Roman5D/Kondrashova_Kochurin/Манипулятор/Картинки/Пример робота.jpg

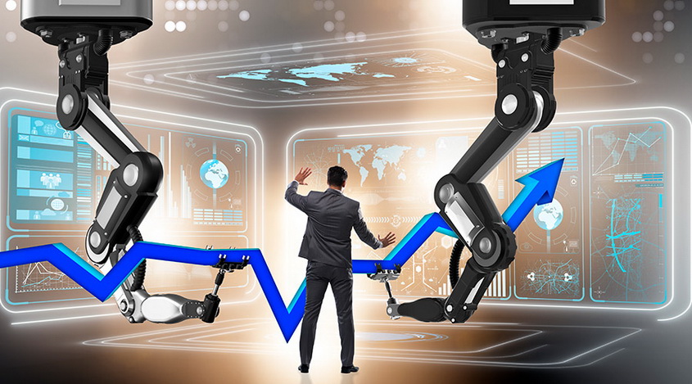
Манипулятор/Картинки/Пример робота.jpg
