Roman5D/Kondrashova_Kochurin/README.md

# Kondrashova_Kochurin
3341506/10401

В фалах main есть секции, в которых производится чтение mat файлов и вывод графиков (никаких долгих пересчётов).
