Roman5D/Kondrashova_Kochurin/Манипулятор/Картинки/Cхема 1.png

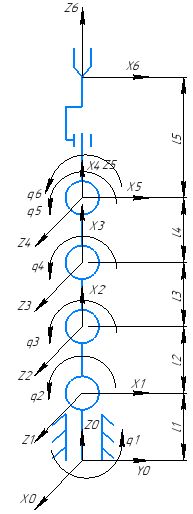
Манипулятор/Картинки/Cхема 1.png
