Roman5D/Kondrashova_Kochurin/Объединение/Scaling.png

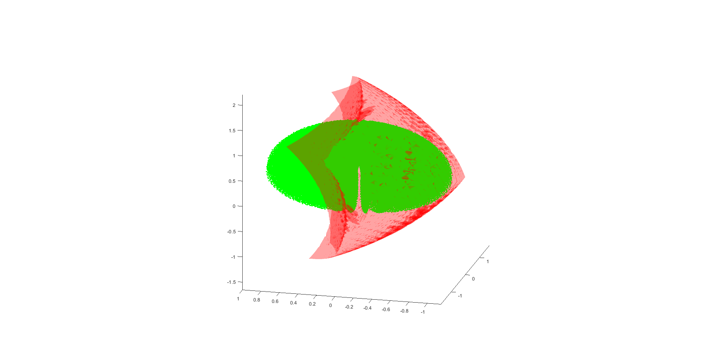
Объединение/Scaling.png
