Roman5D/Kondrashova_Kochurin/Дельта робот/3D-модель дельта-робота/DELTA_SB.SLDASM

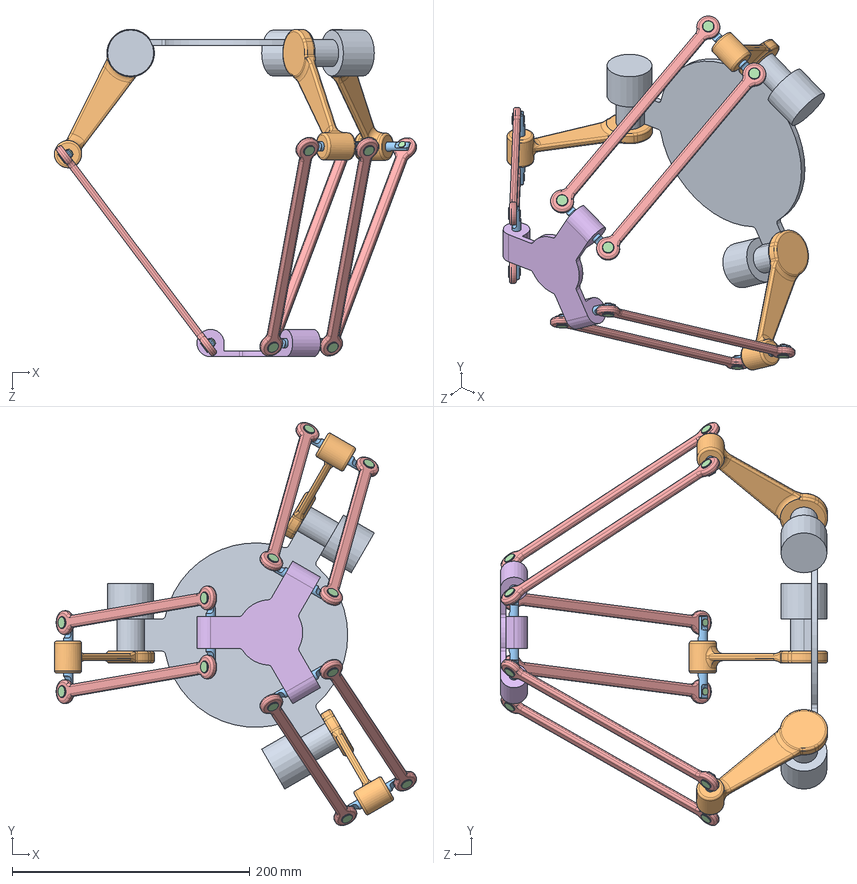
[picture p48: CAD file, 2022-03-20]
Дельта робот/3D-модель дельта-робота/DELTA_SB.SLDASM
304.6 x 338.8 x 275.3 mm
plactina_1
richag x 3
val x 6
vtulka x 12
spica x 6
plastina_2
