Roman5D/Kondrashova_Kochurin/Дельта робот/3D-модель дельта-робота/richag.SLDPRT

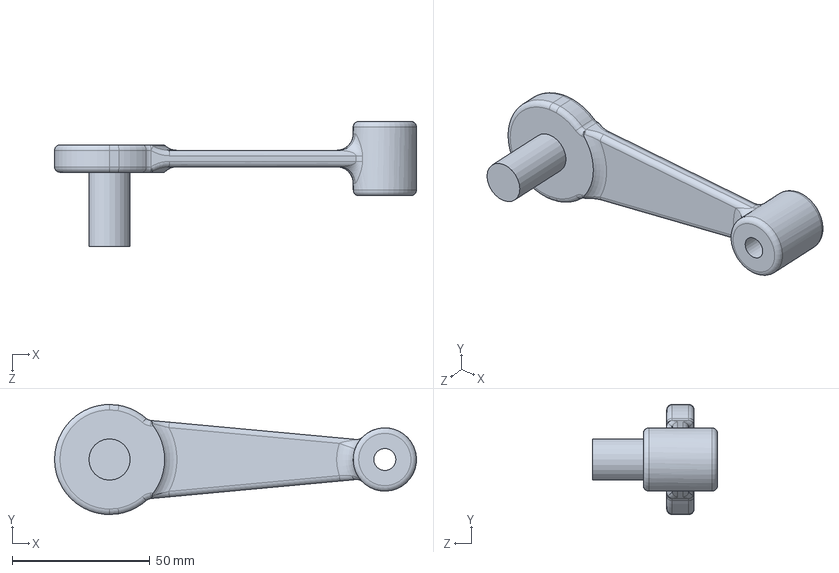
[picture p49: CAD file, 2022-03-20]
Дельта робот/3D-модель дельта-робота/richag.SLDPRT
131.5 x 40.0 x 45.5 mm
