Roman5D/Kondrashova_Kochurin/Манипулятор/Компоненты/Модель csf-mini с сайта/CSF_14_30_1U_CC_F_1.stp

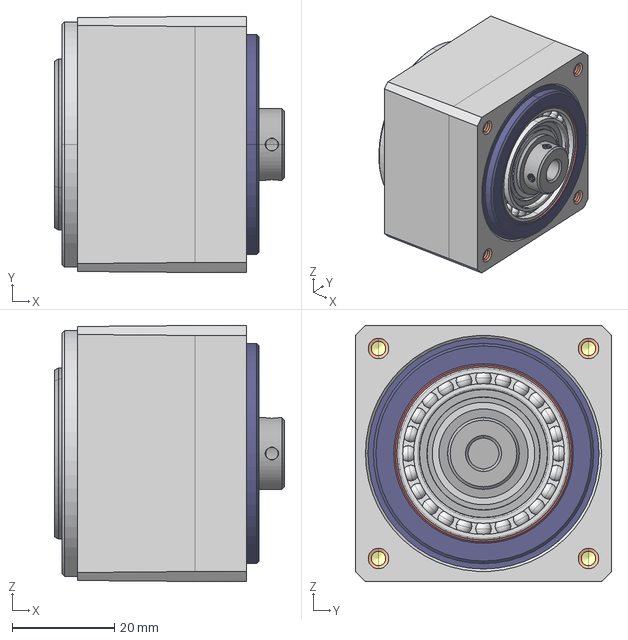
[picture p50: CAD file, 2022-05-11]
Манипулятор/Компоненты/Модель csf-mini с сайта/CSF_14_30_1U_CC_F_1.stp
45.0 x 50.0 x 50.0 mm
