Roman5D/Kondrashova_Kochurin/Дельта робот/3D-модель дельта-робота/val.SLDPRT

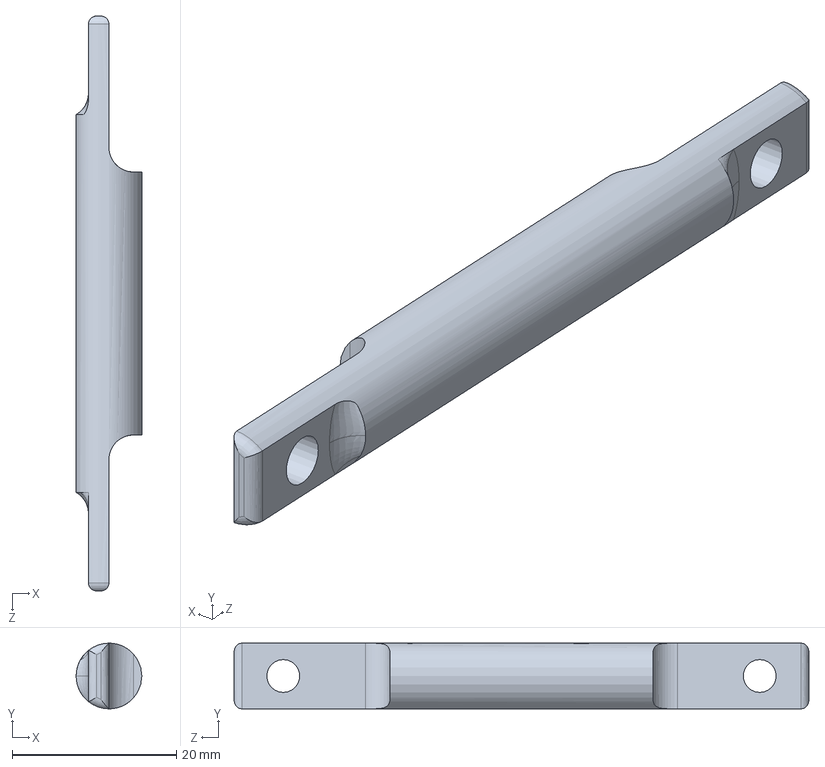
[picture p51: CAD file, 2022-03-20]
Дельта робот/3D-модель дельта-робота/val.SLDPRT
8.00 x 8.00 x 70.0 mm
