Roman5D/Kondrashova_Kochurin/Дельта робот/3D-модель дельта-робота/vtulka.SLDPRT

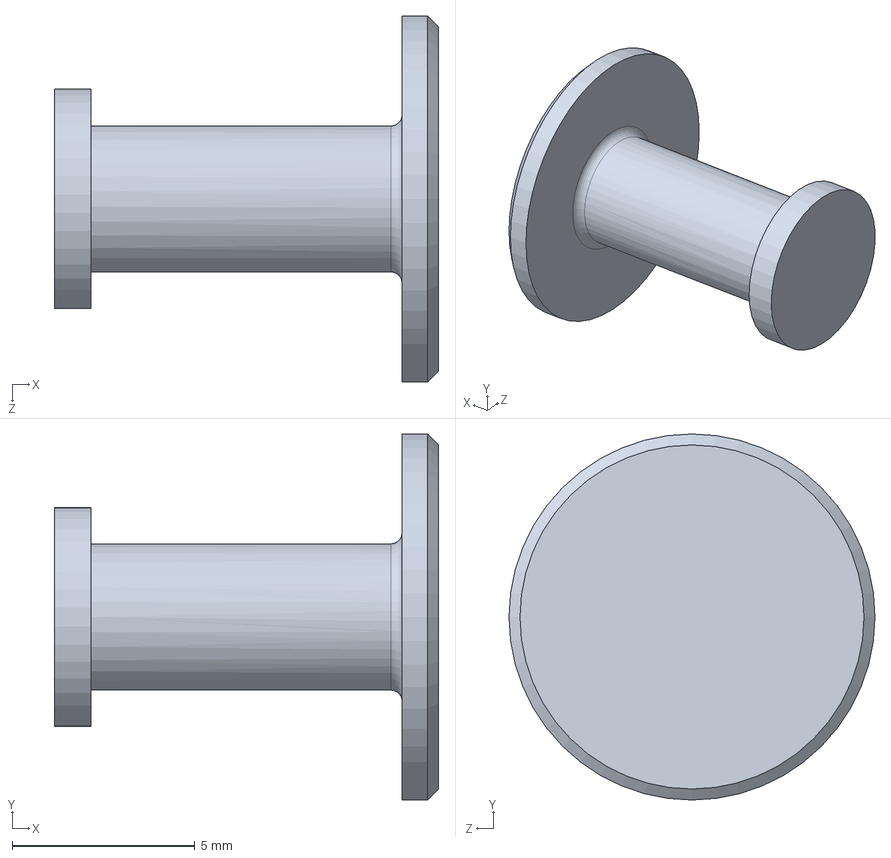
[picture p52: CAD file, 2022-03-20]
Дельта робот/3D-модель дельта-робота/vtulka.SLDPRT
10.5 x 10.0 x 10.0 mm
