Roman5D/Kondrashova_Kochurin/Дельта робот/3D-модель дельта-робота/plastina_2.SLDPRT

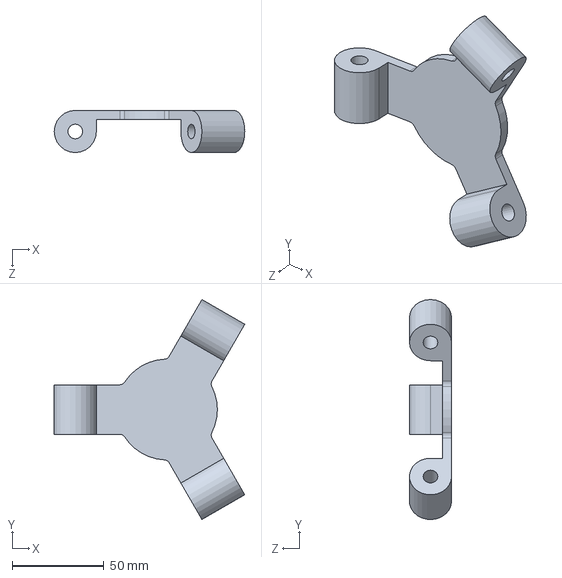
[picture p53: CAD file, 2022-03-20]
Дельта робот/3D-модель дельта-робота/plastina_2.SLDPRT
103.9 x 120.0 x 23.0 mm
