Roman5D/Kondrashova_Kochurin/Дельта робот/3D-модель дельта-робота/spica.SLDPRT

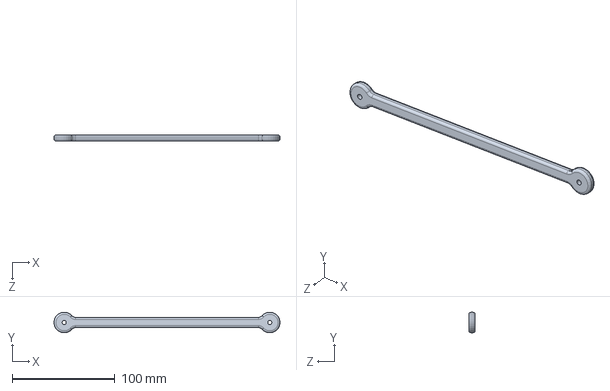
[picture p54: CAD file, 2022-03-20]
Дельта робот/3D-модель дельта-робота/spica.SLDPRT
219.9 x 19.9 x 6.00 mm
