Roman5D/Kondrashova_Kochurin/Дельта робот/3D-модель дельта-робота/plactina_1.SLDPRT

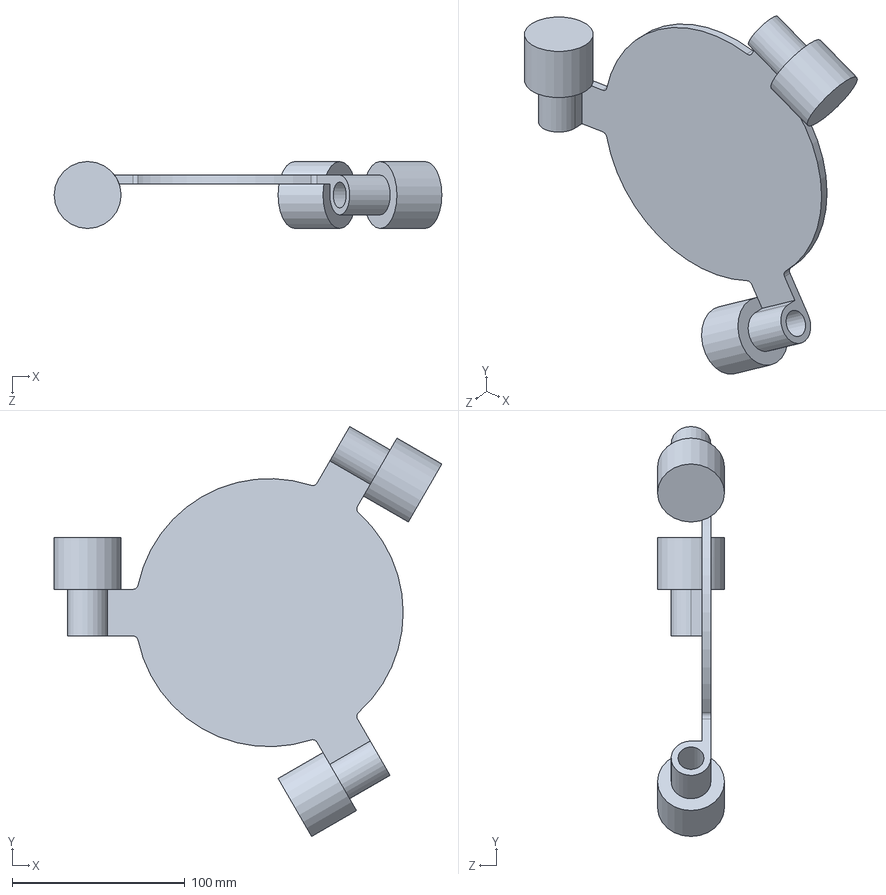
[picture p55: CAD file, 2022-03-20]
Дельта робот/3D-модель дельта-робота/plactina_1.SLDPRT
224.2 x 237.1 x 38.7 mm
