Roman5D/Kondrashova_Kochurin/Манипулятор/Компоненты/Шарнир 4.pdf

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

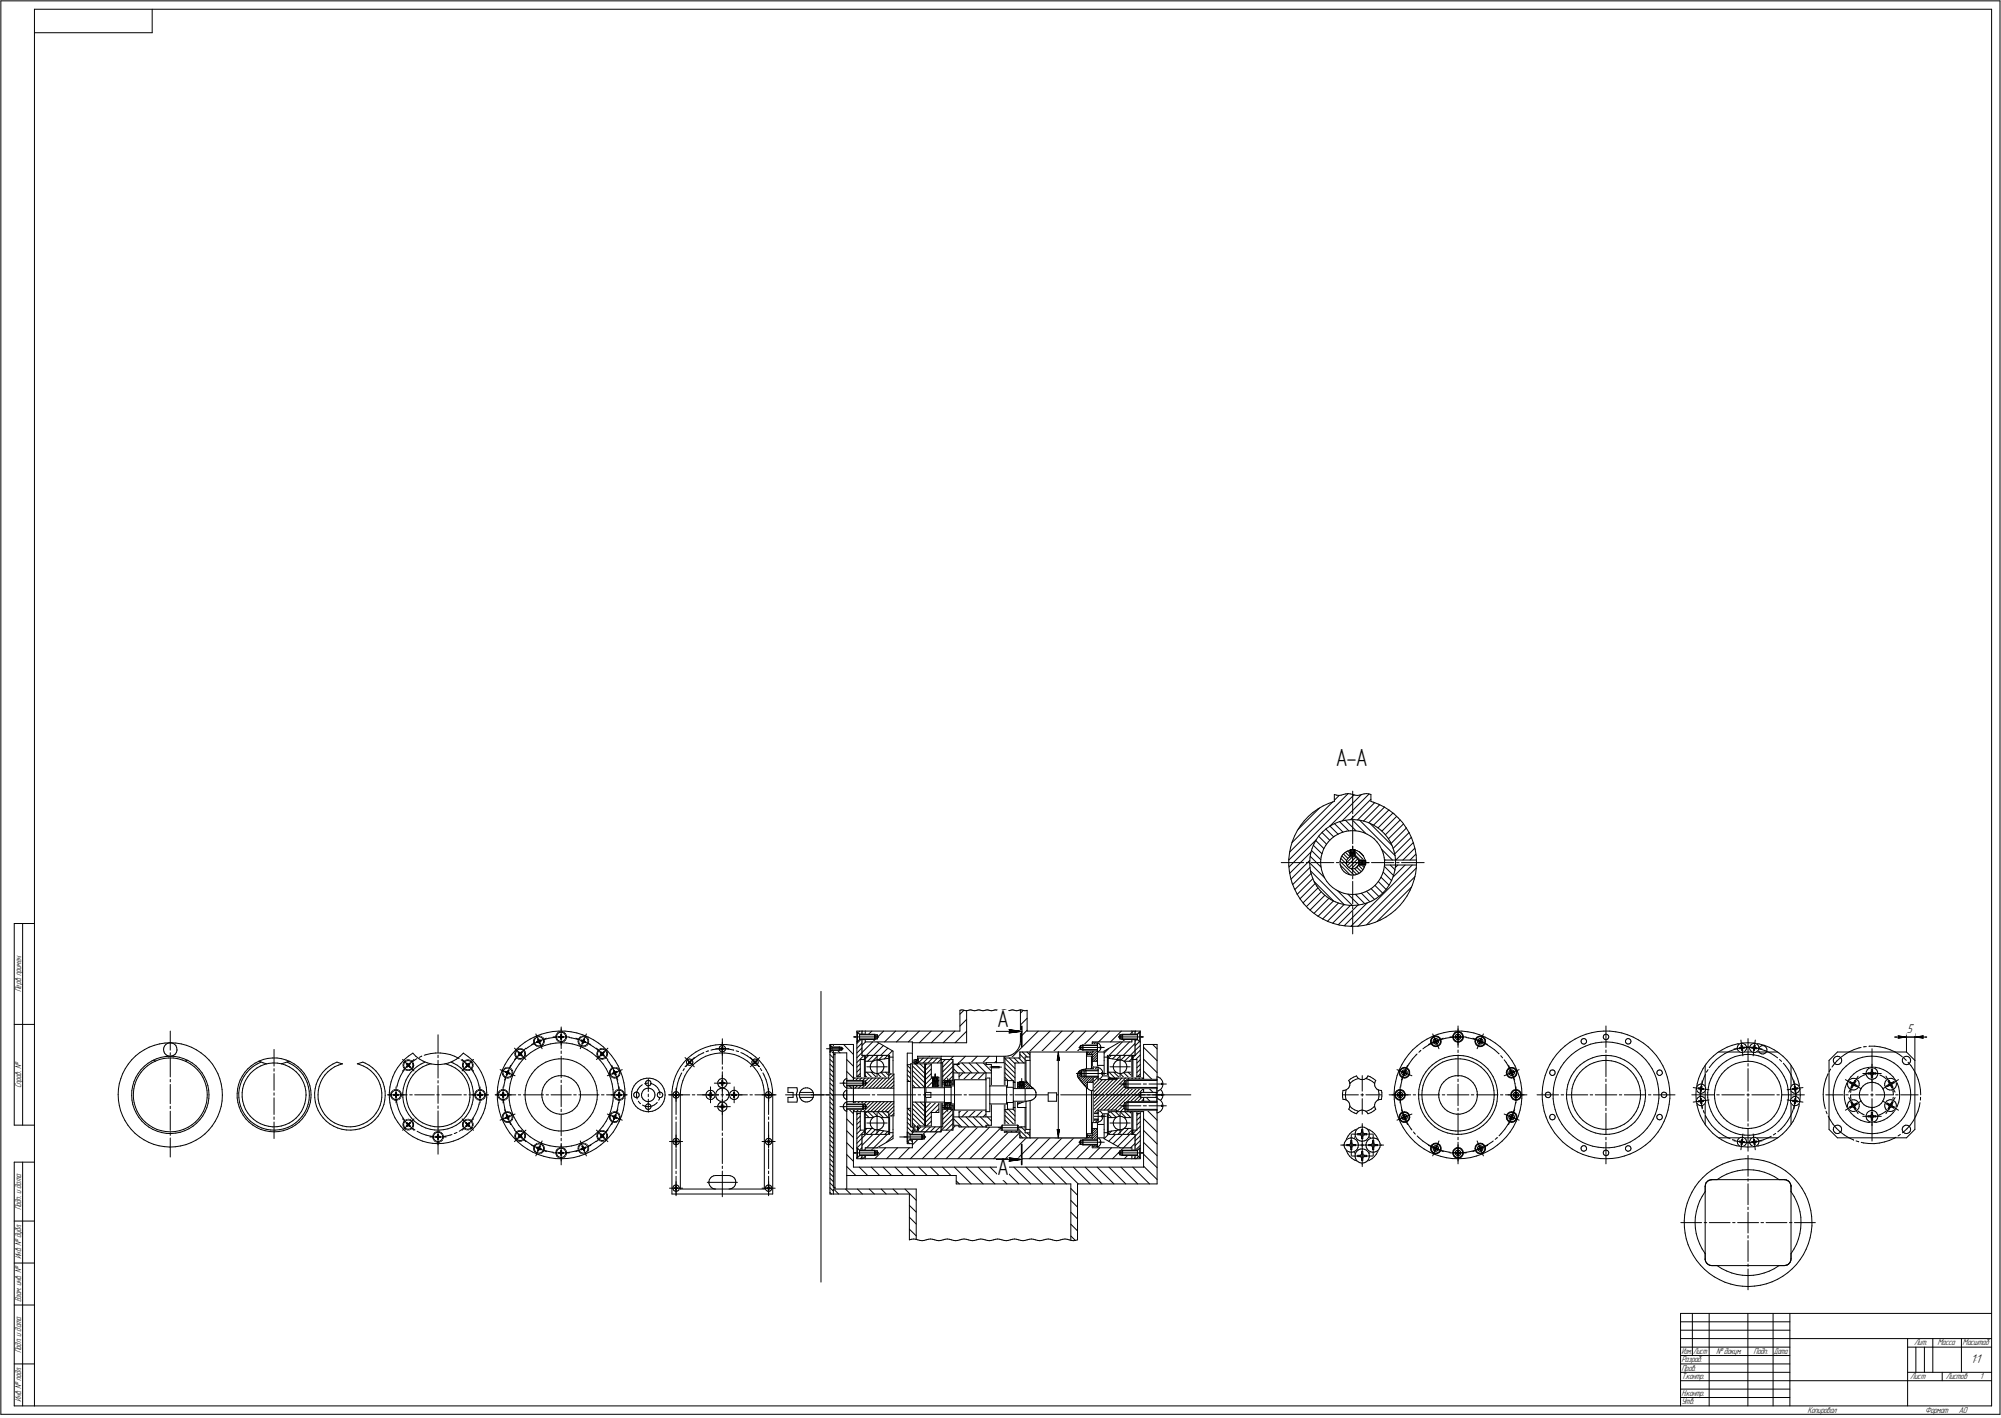
[picture p56: page 1]
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
