Roman5D/Kondrashova_Kochurin/(commit log)

2022-03-20 Вывод из сохраненного
    Исправлены старые ошибки, добавлены новые ошибки
2022-03-26 Мелкие правки
2022-03-28 Добавлен сохранение и загрузка
    Сохранение и загрузка объединённых зон
2022-04-30 Последняя версия файлов
    Началась работа над чертежами
    [CSG_25_50_2UH_1.stp]
2022-05-01 Отчёт обновлён
2022-05-01 Добавлен чертёж 4-го шарнира
    [CSG_25_50_2UH_1.stp]
2022-05-02 Исправил отображение подшипников
2022-05-11 Шарнир №4, который пятый
    Исправлен чертёж шарнира.
    Добавлена модель редуктора с сайта производителя.
    Небольшие правки отчёта
    [CSF_14_30_1U_CC_F_1.stp]
2022-05-11 Мелкая правка
    Исправил отверстие для крепления в корпусе
2022-05-11 Исправления и добавления
    Заменил датчик угла пятого шарнира.
    Добавил общую концепцию компонентов пятого шарнира.
2022-05-20 Шарнир 6
    Добавил концепцию шарнира 6 (он же седьмой, который схват).
    Мелкие правки четвёртого и пятого шарниров.
2022-05-25 Читать описание
    Внесены исправления в шарнир 4, 5 и схват.
    Обновлён отчёт для соответствия чертежам.
    Добавлен файл с кинематическими схемами.
2022-05-26 Исправлен дельта-робот
    и другие мелкие правки
2022-05-29 Итоговые изменения
    Внесены последние исправления
2022-05-29 Добавлены файлы для компаса v16.1
